ZakharSergeevich/telemetry_box_pcb/docs/Полезная информация для проектирования.docx

Полезная информация для проектирования

1) Tag-Connect TC2050 10-pin pinout

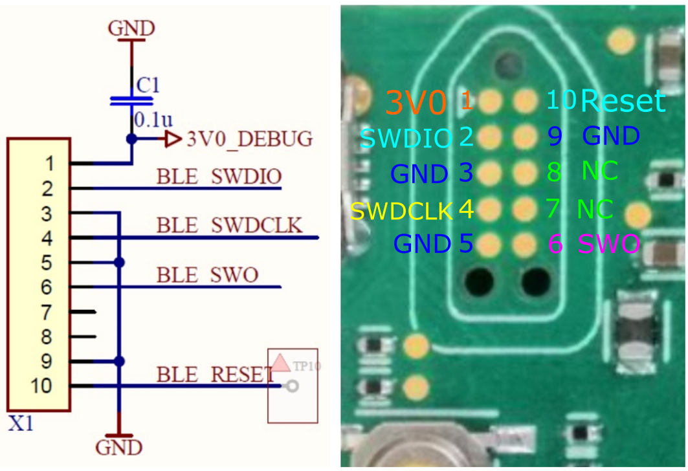
[picture p1: figure]
Рис. 3 FootPrint target устройства

https://habr.com/ru/articles/735422/

2) Пример активной GPS антенны

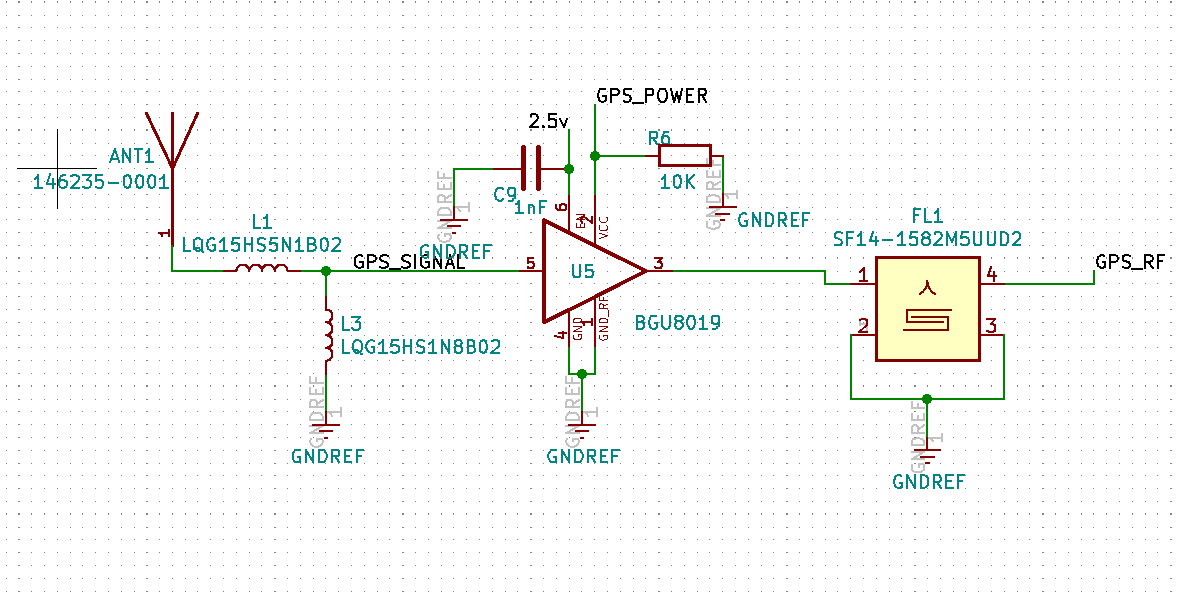
[picture p2: figure]
GPS antenna & amplifier schematic

https://electronics.stackexchange.com/questions/529890/gps-antenna-reference-design
