ZakharSergeevich/telemetry_box_pcb/to_PCBWay/bom/telemetry_box_01_BOM.xlsx

Item # | *Designator | *Qty | Manufacturer | *Mfg Part # | Description / Value | *Package/Footprint | Type | Your Instructions / Notes
1 | A2 | 1 | Taoglas | PCS.68.A | Antennas PCS.68.A Wideband 5G/4G PCB SMD Antenna | 42mm * 10mm | SMD
2 | C1, C2, C6, C7, C44, C45, C46 | 7 | Samsung Electro-Mechanics | CL10A226MO7JZNC | Multilayer Ceramic Capacitors MLCC - SMD/SMT 22uF+/-20% 16V X5R 1 0603 | 603 | SMD
3 | C3, C4, C5, C8, C15, C17, C22, C24, C25, C26, C29, C31, C41 | 13 | Samsung Electro-Mechanics | CL03A104KA3NNNC | Multilayer Ceramic Capacitors MLCC - SMD/SMT 100nF+/-10% 25V X5R 0201 | 201 | SMD
4 | C9 | 1 | Murata | GRM0335C1HR80BA01D | Multilayer Ceramic Capacitors MLCC - SMD/SMT 0.8 pF 50 VDC 0.1 pF 0201 C0G (NP0) | 201 | SMD
5 | C10 | 1 | Murata | GRM0335C1ER50BA01D | Multilayer Ceramic Capacitors MLCC - SMD/SMT 0.5 pF 25 VDC 0.1 pF 0201 C0G (NP0) | 201 | SMD
6 | C11, C12 | 2 | Murata | GRM0335C1E120GA01D | Multilayer Ceramic Capacitors MLCC - SMD/SMT 12 pF 25 VDC 2% 0201 C0G (NP0) | 201 | SMD
7 | C13, C14 | 2 | Murata | GRM0335C1E2R0BA01D | Multilayer Ceramic Capacitors MLCC - SMD/SMT 2 pF 25 VDC 0.1 pF 0201 C0G (NP0) | 201 | SMD
8 | C16, C20, C23, C27, C30, C42, C43 | 7 | Samsung Electro-Mechanics | CL05A106MP5NUNC | Multilayer Ceramic Capacitors MLCC - SMD/SMT 10uF+/-20% 10V X5R 1005 | 402 | SMD
9 | C18 | 1 | Murata | GRM0335C1E101JA01D | Multilayer Ceramic Capacitors MLCC - SMD/SMT 100 pF 25 VDC 5% 0201 C0G (NP0) | 201 | SMD
10 | C32 | 1 | Murata | GRM0335C1E470FA01D | Multilayer Ceramic Capacitors MLCC - SMD/SMT 47 pF 25 VDC 1% 0201 C0G (NP0) | 201 | SMD
11 | C19 | 1 | Murata | GRM0335C1E821JA01D | Multilayer Ceramic Capacitors MLCC - SMD/SMT 820 pF 25 VDC 5% 0201 C0G (NP0) | 201 | SMD
12 | C21, C28, C37, C38 | 4 | Samsung Electro-Mechanics | CL05A105KO5NNNC | Multilayer Ceramic Capacitors MLCC - SMD/SMT 1uF+/-10% 16V X5R 10 0402 | 402 | SMD
13 | C36 | 1 | no | no | no
14 | C39 | 1 | Murata | GRM1555C1H3R3CA01D | Multilayer Ceramic Capacitors MLCC - SMD/SMT 3.3 pF 50 VDC 0.25 pF 0402 C0G (NP0) | 402 | SMD
15 | J1 | 1 | Molex | 78646-3001 | Memory Card Connectors MICRO SIM CON ASSY 1.45HT PUSHPULL 6CKT
16 | J4 | 1 | Amphenol | 12401832E402A | USB Connectors USB TYPE C RCPT R/A top mount dual SMT
17 | L1 | 1 | Murata | DFE201210U-R47M=P2 | Power Inductors - SMD .47 UH 3.0A | 805 | SMD
18 | L2 | 1 | Murata | LQW15AN4N7B00D | RF Inductors - SMD 4.7 NH +-.1NH | 402 | SMD
19 | L3, L5 | 2 | Murata | LQM18DH100M70L | Power Inductors - SMD Fixed IND 10uH 300mA POWRTRN | 603 | SMD
20 | L4 | 1 | Murata | LQW15AN15NJ00D | RF Inductors - SMD 15 NH 5% | 402 | SMD
21 | L6 | 1 | Murata | LQW15AN12NJ00D | RF Inductors - SMD 12 NH 5% | 402 | SMD
22 | R1 | 1 | YAGEO | RC0201FR-07200KL | Thick Film Resistors - SMD 200 kOhms 50mW 0201 1% | 201 | SMD
23 | R2, R3 | 2 | YAGEO | RC0201FR-07100KL | Thick Film Resistors - SMD 100 kOhms 50mW 0201 1% | 201 | SMD
24 | R4 | 1 | YAGEO | RC0201FR-070RL | Thick Film Resistors - SMD 0 Ohms 50mW 0201 1% | 201 | SMD
25 | R10, R11 | 2 | YAGEO | RC0201FR-7D10KL | Thick Film Resistors - SMD 10 kOhms 50 mW 0201 1% | 201 | SMD
26 | R12 | 1 | YAGEO | RC0201FR-072KL | Thick Film Resistors - SMD 2 kOhms 50mW 0201 1% | 201 | SMD
27 | R13, R14 | 2 | YAGEO | RC0201FR-075K1L | Thick Film Resistors - SMD 5.1 kOhms 50 mW 0201 1% | 201 | SMD
28 | S1 | 1 | Same Sky | SLW-108645-4A-RA-D | Slide Switches 10.8 x 6.4 x 5 mm, 4 mm Raised Slide Actuator, Right-Angle, Through Hole |  | DIP
29 | U1 | 1 | Nordic Semiconductor | nRF52840-QIAA-R | RF System on a Chip - SoC nRF52840-QIAA QFN 73L 7x7 | AQFN-73
30 | U2 | 1 |  | A9G | A9G
31 | U3 | 1 | STMicroelectronics | STBC08PMR | Battery Management 800mA Linear Li Ion batery chargr
32 | U4 | 1 | Texas Instruments | TPS7A2633DRVR | LDO Voltage Regulators 500-mA, 18-V, ultra-low-IQ, high-accuracy, adjustable low-dropout voltage regulator with power good 6-WSON -40 to 125
33 | U5 | 1 | Taoglas | SGGP.12.4.A.02 | Antennas SGGP.12.4.A.02 GPS/GLONASS/Galileo 12*12*4mm SMD Mount Patch |  | SMD
34 | U6 | 1 | NXP | BGU8019X | RF Amplifier Low Noise Amplifier MMIC for GPS |  | SMD
35 | U7 | 1 | Analog Devices | ADP150ACBZ-2.8-R7 | Linear Voltage Regulators 150mA LDO 2.8Vout | WLCSP-4 | SMD
36 | Y1 | 1 | ABRACON | ABM11-32.000MHZ-B7G-T | Crystals CRYSTAL 32.0000MHZ 10PF SMD | 2mm * 1.6mm
37 | Y2 | 1 | ABRACON | ABS04W-32.768KHZ-4-D2-T5 | Crystals CRYSTAL 32.768KHZ 4PF SMD | 1.2mm * 1mm
