ZakharSergeevich/telemetry_box_pcb/telemetry_box_01/telemetry_box_01.step

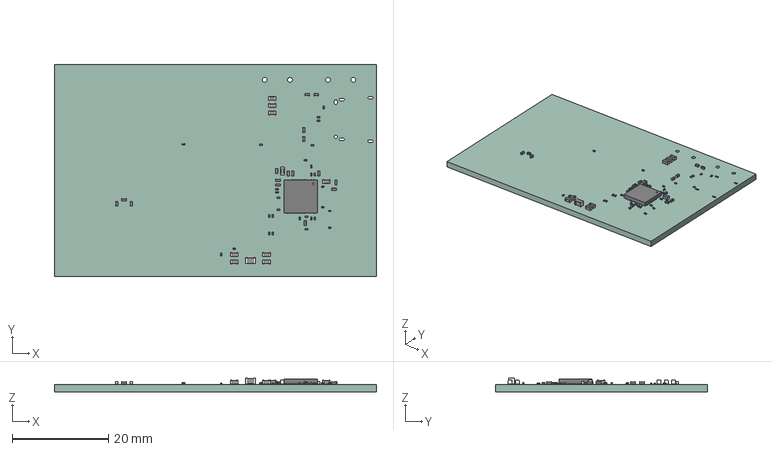
[picture p3: CAD file, 2025-03-20]
telemetry_box_01/telemetry_box_01.step
66.8 x 44.0 x 2.88 mm
telemetry_box_01 PCB
