ZakharSergeevich/telemetry_box_pcb/telemetry_box_01/telemetry_box_01.kicad_pcb

## KiCad design telemetry_box_01/telemetry_box_01.kicad_pcb (2025-06-04)

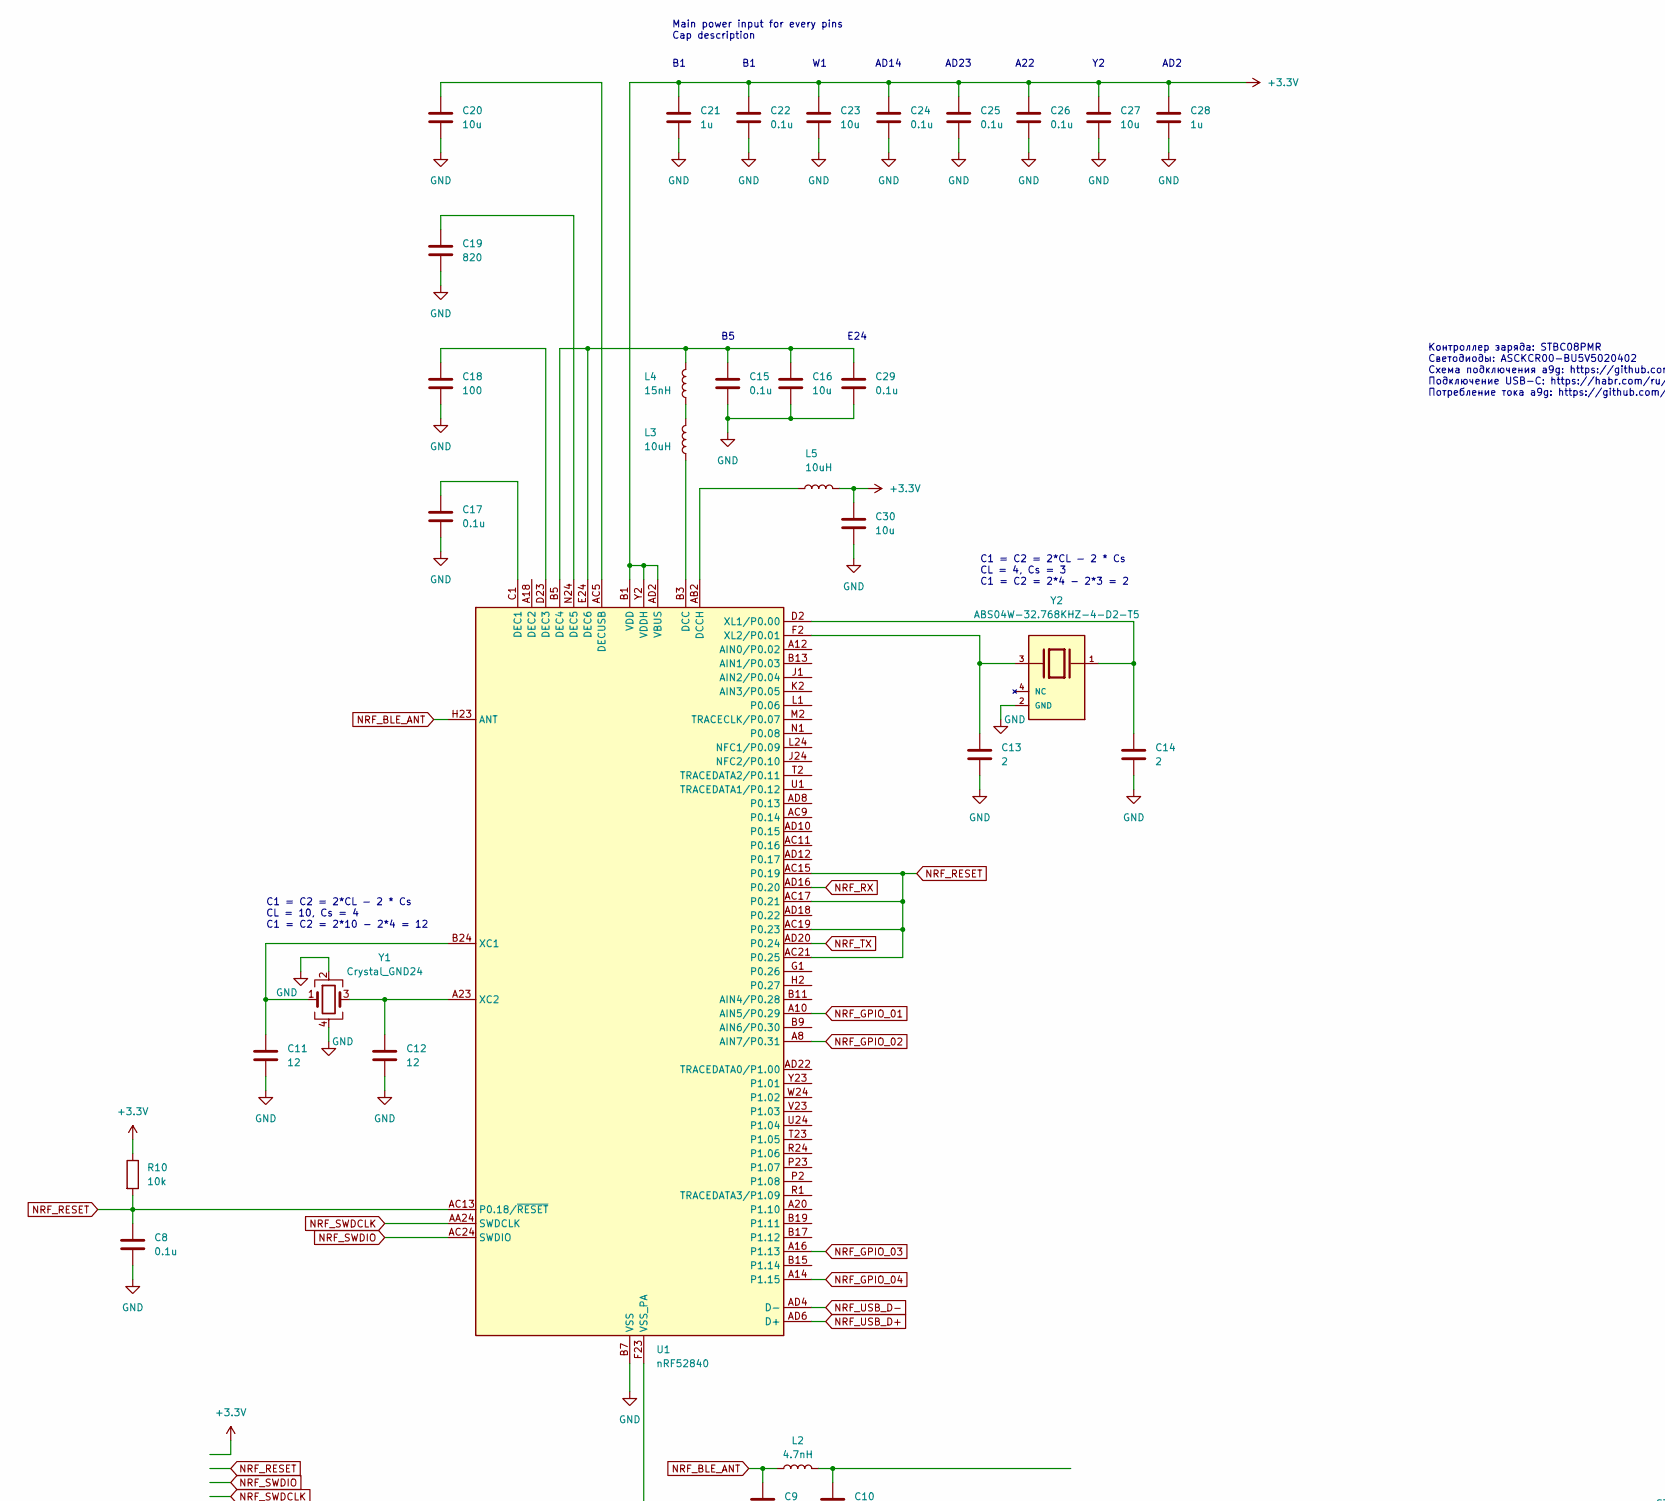
[picture p4: schematic telemetry_box_01.kicad_sch, part in row 1, column 1]

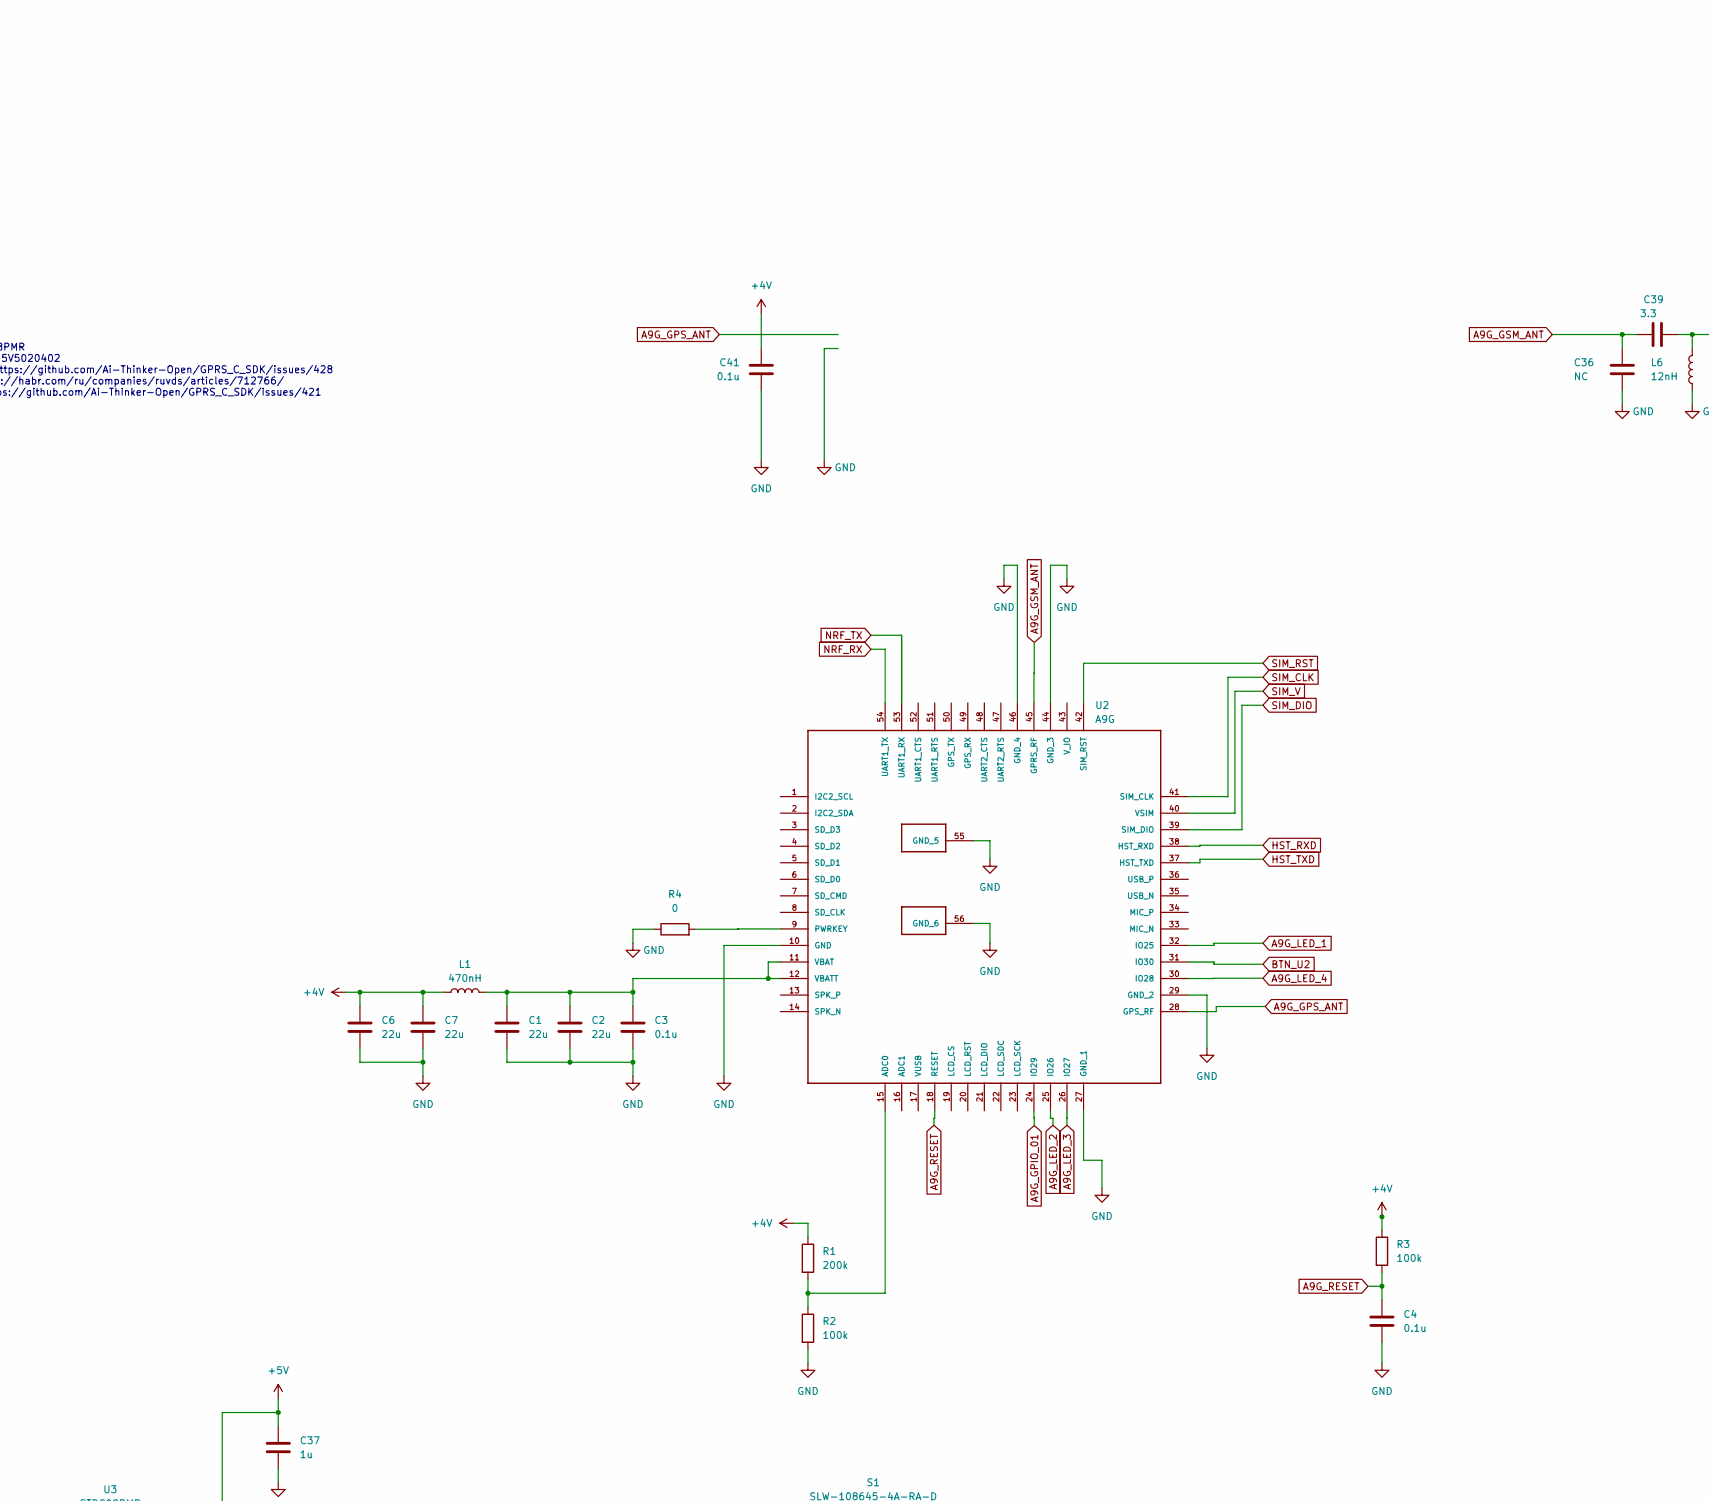
[picture p5: schematic telemetry_box_01.kicad_sch, part in row 1, column 2]

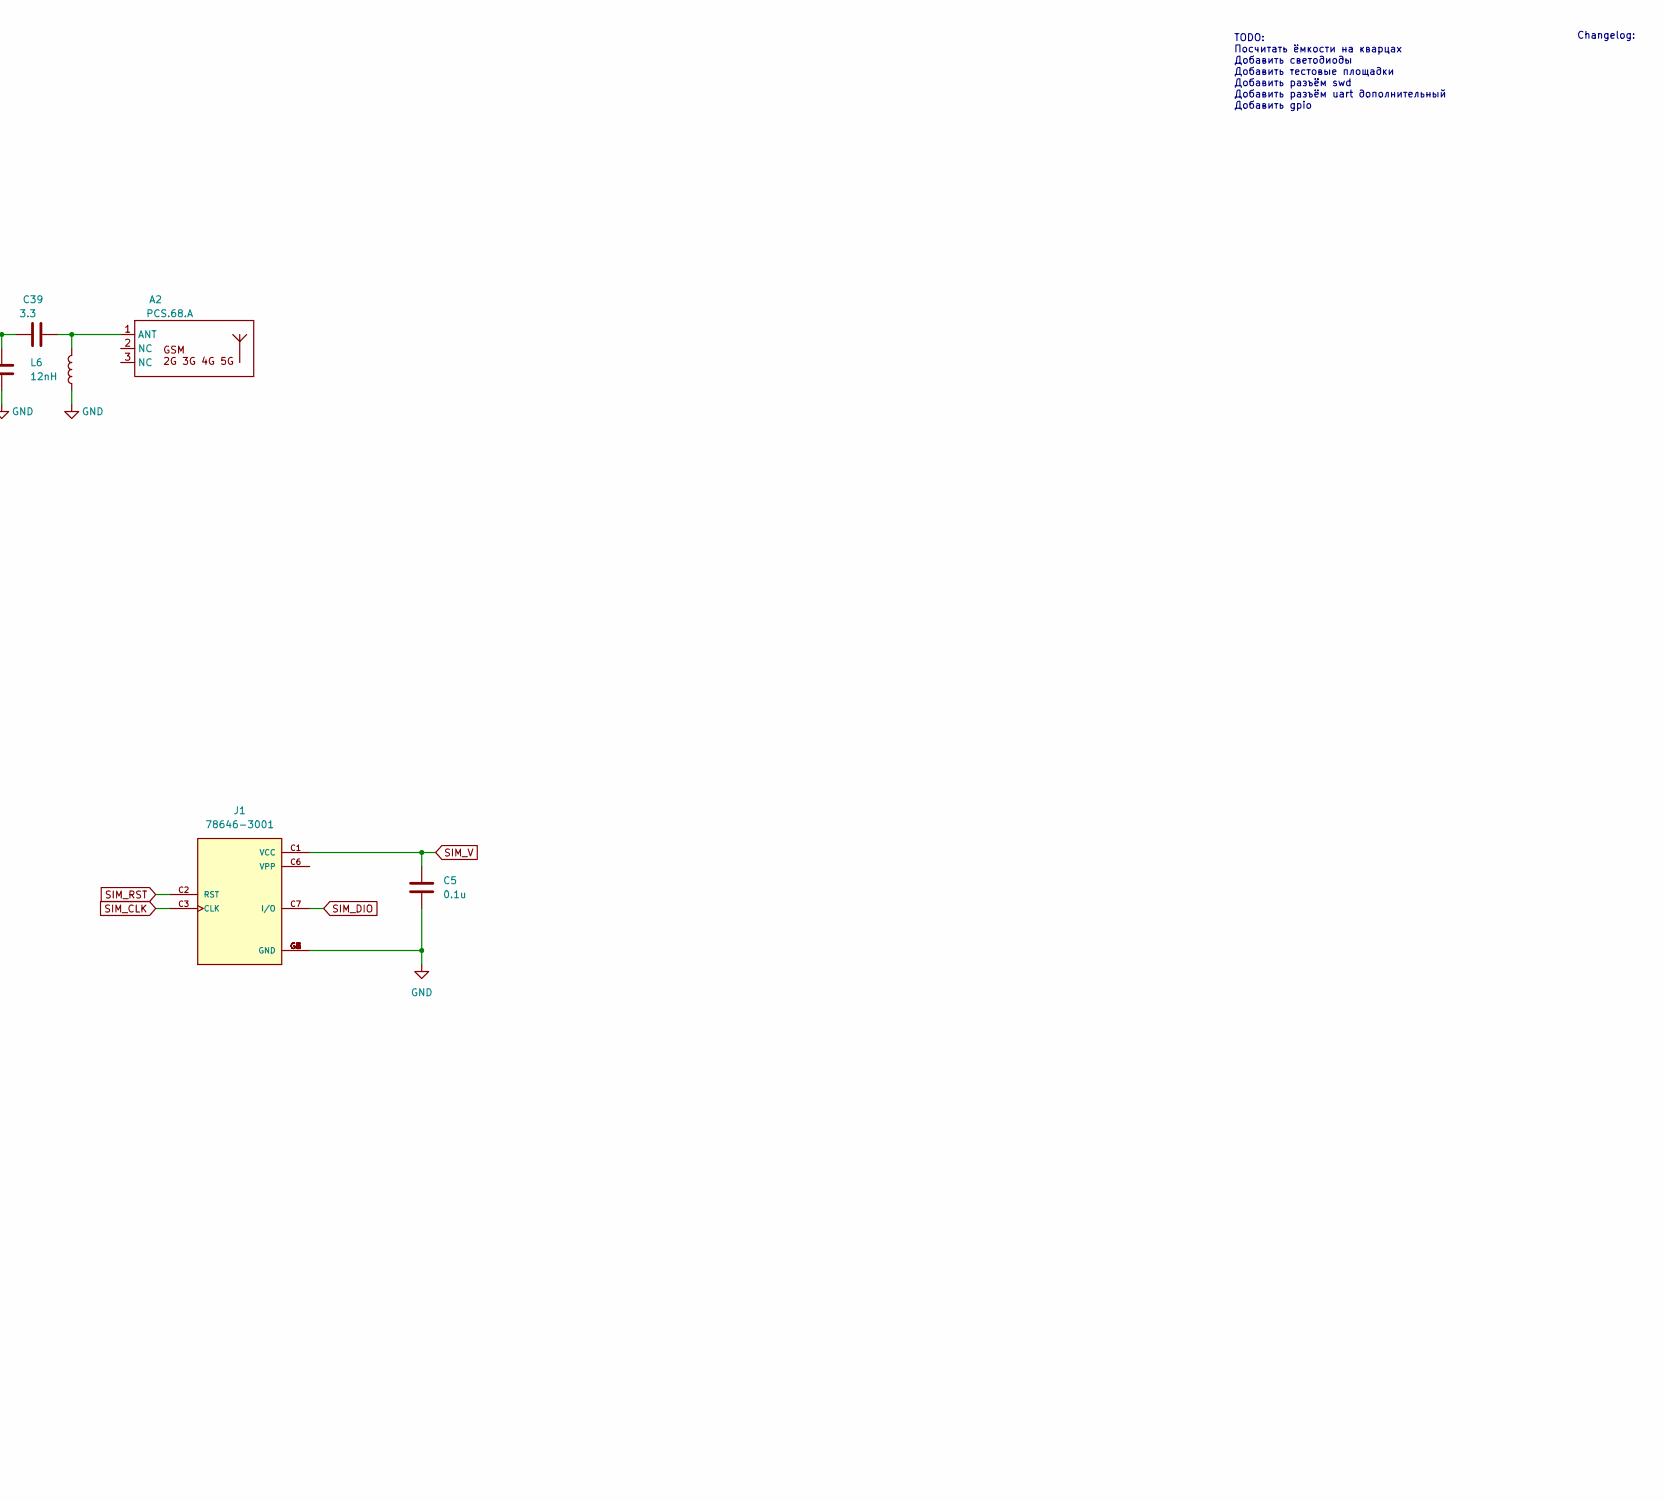
[picture p6: schematic telemetry_box_01.kicad_sch, part in row 1, column 3]

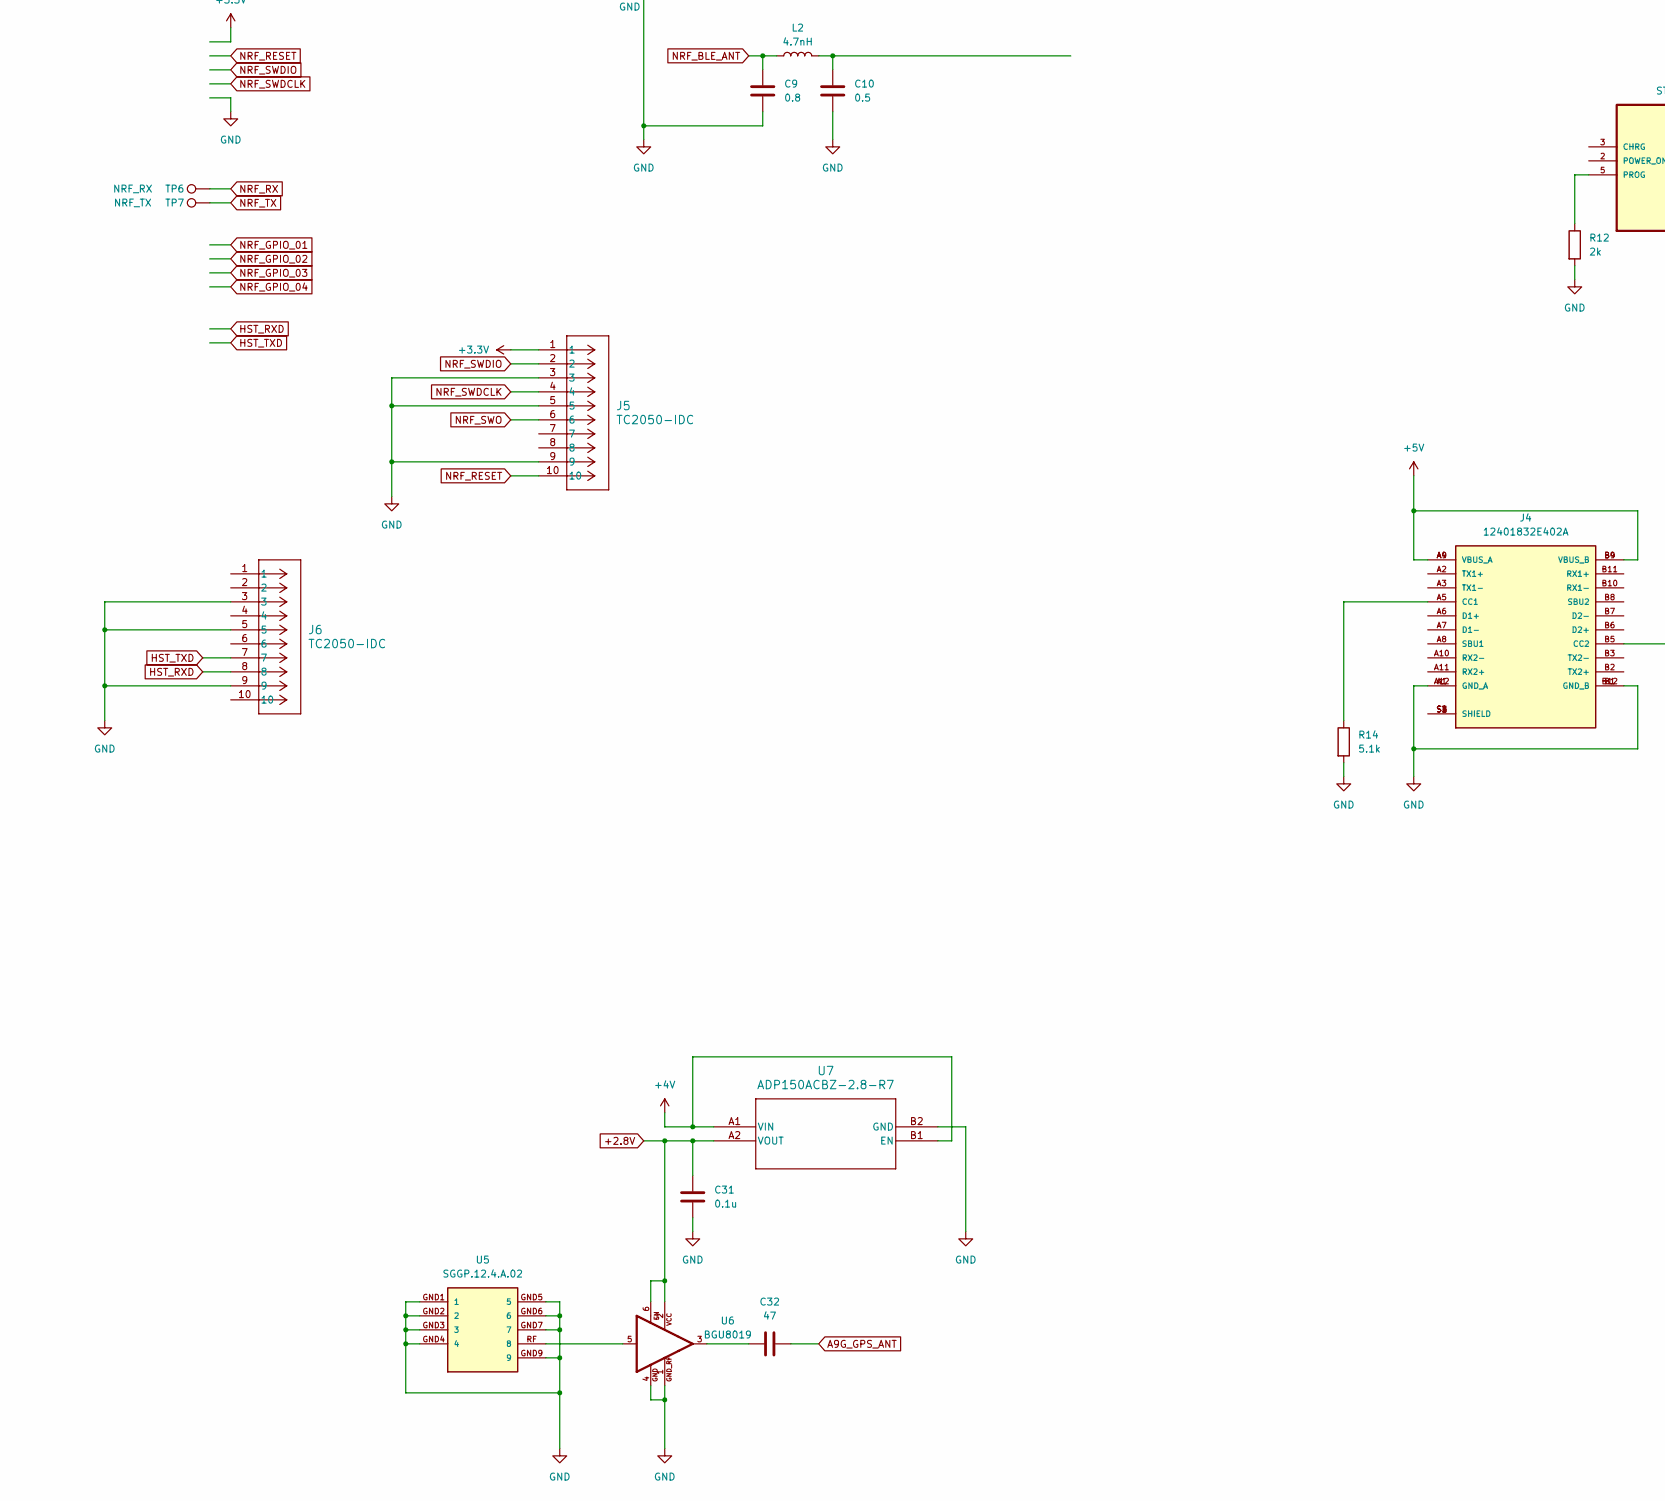
[picture p7: schematic telemetry_box_01.kicad_sch, part in row 2, column 1]

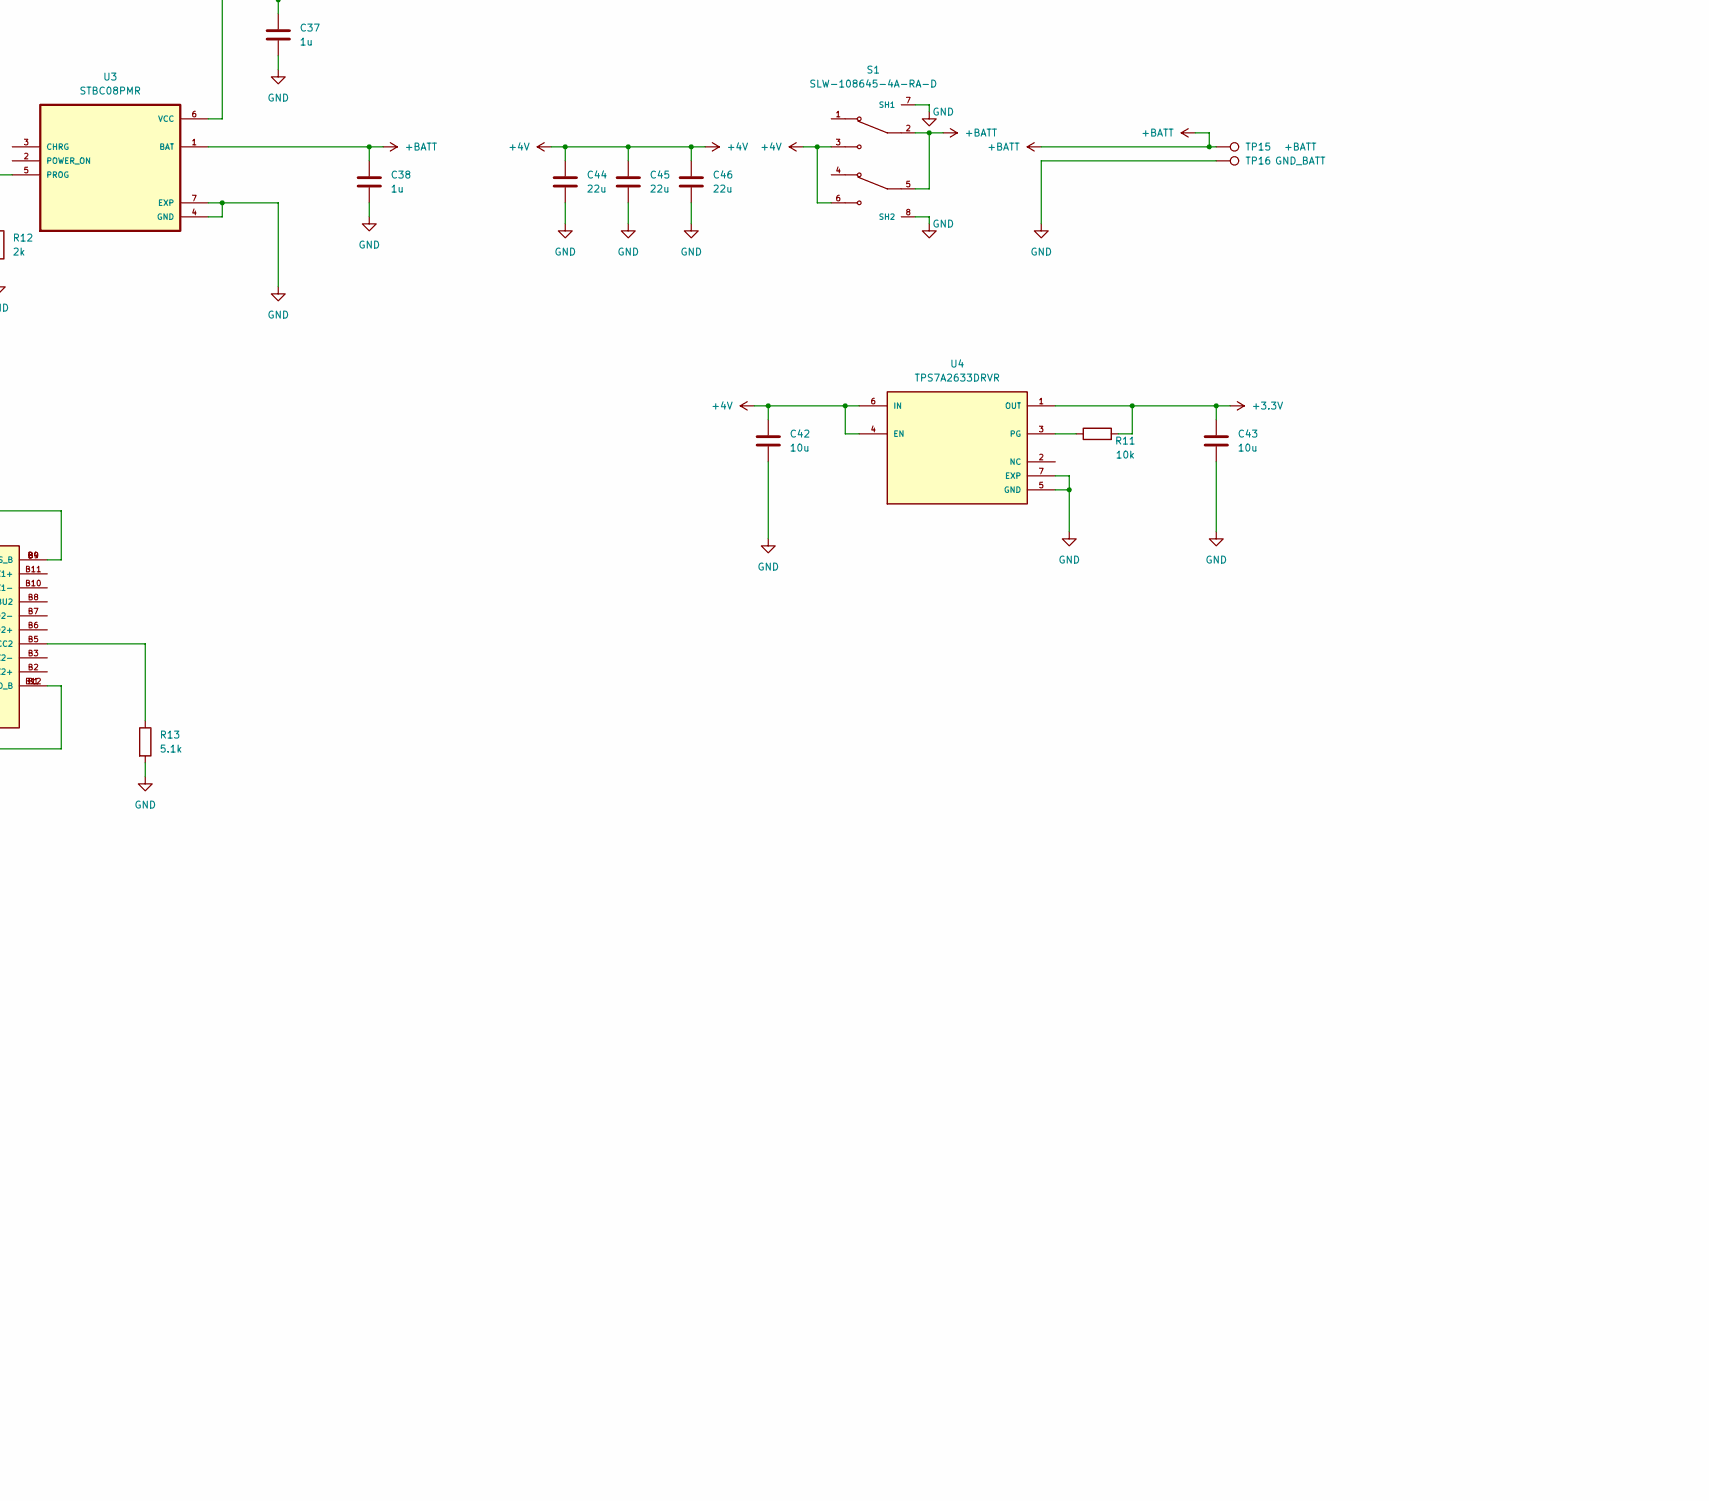
[picture p8: schematic telemetry_box_01.kicad_sch, part in row 2, column 2]

Parts:
A2: PCS.68.A
C1, C2, C6, C7, C44, C45, C46: 22u; C_0603_1608Metric
C3, C4, C5, C8, C15, C17, C22, C24, C25, C26, C29, C31, C41: 0.1u; C_0201_0603Metric
C9: 0.8; C_0201_0603Metric
C10: 0.5; C_0201_0603Metric
C11, C12: 12; C_0201_0603Metric
C13, C14: 2; C_0201_0603Metric
C16, C20, C23, C27, C30, C42, C43: 10u; C_0402_1005Metric
C18: 100; C_0201_0603Metric
C19: 820; C_0201_0603Metric
C21, C28, C37, C38: 1u; C_0402_1005Metric
C32: 47; C_0201_0603Metric
C36: NC; C_0402_1005Metric
C39: 3.3; C_0402_1005Metric
J1: 78646-3001; MOLEX_78646-3001; DIGI-KEY_PART_NUMBER WM9364CT-ND
J4: 12401832E402A; AMPHENOL_12401832E402A; PARTREV X2
J5, J6: TC2050-IDC; CONN_TC2050-IDC_TGC
L1: 470nH; L_0805_2012Metric_Pad1.15x1.40mm_HandSolder
L2: 4.7nH; L_0402_1005Metric
L3, L5: 10uH; L_0603_1608Metric
L4: 15nH; L_0402_1005Metric
L6: 12nH; L_0402_1005Metric
R1: 200k; R_0201_0603Metric
R2, R3: 100k; R_0201_0603Metric
R4: 0; R_0201_0603Metric
R10, R11: 10k; R_0201_0603Metric
R12: 2k; R_0201_0603Metric
R13, R14: 5.1k; R_0201_0603Metric
S1: SLW-108645-4A-RA-D; SW_SLW-108645-4A-RA-D; PARTREV 1.01
TP6: NRF_RX; TestPoint_Pad_D2.0mm
TP7: NRF_TX; TestPoint_Pad_D2.0mm
TP15: +BATT; TestPoint_THTPad_D2.0mm_Drill1.0mm
TP16: GND_BATT; TestPoint_THTPad_D2.0mm_Drill1.0mm
U1: nRF52840; Nordic_AQFN-73-1EP_7x7mm_P0.5mm
U2: A9G; A9
U3: STBC08PMR; SON95P300X300X100-7N; PARTREV 4
U4: TPS7A2633DRVR; SON65P200X200X80-7N
U5: SGGP.12.4.A.02
U6: BGU8019; SOT1232
U7: ADP150ACBZ-2.8-R7; CB_4_3_ADI
Y1: Crystal_GND24; Crystal_SMD_2016-4Pin_2.0x1.6mm
Y2: ABS04W-32.768KHZ-4-D2-T5; XTAL_ABS04W-32.768KHZ-4-D2-T5; PARTREV 12.18.2018

Connections:
+2.8V: C31.1, U6.2, U6.6, U7.A2 (VOUT)
+3.3V: C21.1, C22.1, C23.1, C24.1, C25.1, C26.1, C27.1, C28.1, C30.1, C43.1, J5.1, L5.2, R10.1, R11.2, U1.A22 (VDD), U1.AD2 (VBUS), U1.AD14 (VDD), U1.AD23 (VDD), U1.B1 (VDD), U1.W1 (VDD), U1.Y2 (VDDH), U4.1 (OUT)
+4V: C6.1, C7.1, C41.1, C42.1, C44.1, C45.1, C46.1, L1.1, R1.1, R3.1, S1.3, S1.6, U4.4 (EN), U4.6 (IN), U7.A1 (VIN), U7.B1 (EN)
+5V: C37.1, J4.A4 (VBUS_A), J4.A9 (VBUS_A), J4.B4 (VBUS_B), J4.B9 (VBUS_B), U3.6 (VCC)
+BATT: C38.1, S1.2, S1.5, TP15.1, U3.1 (BAT)
A9G_GPIO_01: U2.24 (IO29)
A9G_GPS_ANT: C32.2, U2.28 (GPS_RF)
A9G_GSM_ANT: C36.1, C39.1, U2.45 (GPRS_RF)
A9G_LED_1: U2.32 (IO25)
A9G_LED_2: U2.25 (IO26)
A9G_LED_3: U2.26 (IO27)
A9G_LED_4: U2.30 (IO28)
A9G_RESET: C4.1, R3.2, U2.18 (RESET)
BTN_U2: U2.31 (IO30)
GND: C1.2, C2.2, C3.2, C4.2, C5.2, C6.2, C7.2, C8.2, C9.2, C10.2, C11.2, C12.2, C13.2, C14.2, C15.2, C16.2, C17.2, C18.2, C19.2, C20.2, C21.2, C22.2, C23.2, C24.2, C25.2, C26.2, C27.2, C28.2, C29.2, C30.2, C31.2, C36.2, C37.2, C38.2, C41.2, C42.2, C43.2, C44.2, C45.2, C46.2, J1.C5 (GND), J1.G1 (GND), J1.G2 (GND), J1.G3 (GND), J1.G4 (GND), J1.G5 (GND), J1.G6 (GND), J4.A1 (GND_A), J4.A12 (GND_A), J4.B1 (GND_B), J4.B12 (GND_B), J5.3, J5.5, J5.9, J6.3, J6.5, J6.9, L6.1, R2.2, R4.1, R12.2, R13.2, R14.2, S1.7 (SH1), S1.8 (SH2), TP16.1, U1.B7 (VSS), U1.EP (VSS), U1.F23 (VSS_PA), U2.10 (GND), U2.27 (GND_1), U2.29 (GND_2), U2.44 (GND_3), U2.46 (GND_4), U2.55 (GND_5), U2.56 (GND_6), U3.4 (GND), U3.7 (EXP), U4.5 (GND), U4.7 (EXP), U5.GND1 (1), U5.GND2 (2), U5.GND3 (3), U5.GND4 (4), U5.GND5 (5), U5.GND6 (6), U5.GND7 (7), U5.GND9 (9), U6.1, U6.4, U7.B2 (GND), Y1.2, Y1.4, Y2.2 (GND)
HST_RXD: J6.8, U2.38 (HST_RXD)
HST_TXD: J6.7, U2.37 (HST_TXD)
NRF_BLE_ANT: C9.1, L2.1, U1.H23 (ANT)
NRF_GPIO_01: U1.A10 (AIN5/P0.29)
NRF_GPIO_02: U1.A8 (AIN7/P0.31)
NRF_GPIO_03: U1.A16 (P1.13)
NRF_GPIO_04: U1.A14 (P1.15)
NRF_RESET: C8.1, J5.10, R10.2, U1.AC13 (P0.18/~RESET), U1.AC15 (P0.19), U1.AC17 (P0.21), U1.AC19 (P0.23), U1.AC21 (P0.25)
NRF_RX: TP6.1, U1.AD16 (P0.20), U2.54 (UART1_TX)
NRF_SWDCLK: J5.4, U1.AA24 (SWDCLK)
NRF_SWDIO: J5.2, U1.AC24 (SWDIO)
NRF_SWO: J5.6
NRF_TX: TP7.1, U1.AD20 (P0.24), U2.53 (UART1_RX)
NRF_USB_D+: U1.AD6 (D+)
NRF_USB_D-: U1.AD4 (D-)
unnamed: A2.1 (ANT), C39.2, L6.2
unnamed: C10.1, L2.2
unnamed: C32.1, U6.3
unnamed: J4.A5 (CC1), R14.1
unnamed: J4.B5 (CC2), R13.1
unnamed: J4.S1 (SHIELD), J4.S2 (SHIELD), J4.S3 (SHIELD), J4.S4 (SHIELD)
unnamed: L3.2, L4.1
unnamed: L3.1, U1.B3 (DCC)
unnamed: L5.1, U1.AB2 (DCCH)
unnamed: C17.1, U1.C1 (DEC1)
unnamed: C18.1, U1.D23 (DEC3)
unnamed: C15.1, C16.1, C29.1, L4.2, U1.B5 (DEC4), U1.E24 (DEC6)
unnamed: C19.1, U1.N24 (DEC5)
unnamed: C20.1, U1.AC5 (DECUSB)
unnamed: C11.1, U1.B24 (XC1), Y1.1
unnamed: C12.1, U1.A23 (XC2), Y1.3
unnamed: C14.1, U1.D2 (XL1/P0.00), Y2.1
unnamed: C13.1, U1.F2 (XL2/P0.01), Y2.3
unnamed: R1.2, R2.1, U2.15 (ADC0)
unnamed: R4.2, U2.9 (PWRKEY)
unnamed: C1.1, C2.1, C3.1, L1.2, U2.11 (VBAT), U2.12 (VBATT)
unnamed: R12.1, U3.5 (PROG)
unnamed: R11.1, U4.3 (PG)
unnamed: U5.RF (8), U6.5
SIM_CLK: J1.C3 (CLK), U2.41 (SIM_CLK)
SIM_DIO: J1.C7 (I/O), U2.39 (SIM_DIO)
SIM_RST: J1.C2 (RST), U2.42 (SIM_RST)
SIM_V: C5.1, J1.C1 (VCC), U2.40 (VSIM)

Notes on the sheet:
C1 = C2 = 2*CL - 2 * Cs CL = 4, Cs = 3 C1 = C2 = 2*4 - 2*3 = 2
Changelog:
A22
C1 = C2 = 2*CL - 2 * Cs CL = 10, Cs = 4 C1 = C2 = 2*10 - 2*4 = 12
E24
Main power input for every pins Cap description
AD14
AD23
TODO: Посчитать ёмкости на кварцах Добавить светодиоды Добавить тестовые площадки Добавить разъём swd Добавить разъём uart дополнительный Добавить gpio
AD2
Контроллер заряда: STBC08PMR Светодиоды: ASCKCR00-BU5V5020402 Схема подключения a9g: https://github.com/Ai-Thinker-Open/GPRS_C_SDK/issues/428 Подключение USB-C: https://habr.com/ru/companies/ruvds/articles/712766/ Потребление тока a9g: https://github.com/Ai-Thinker-Open/GPRS_C_SDK/issues/421

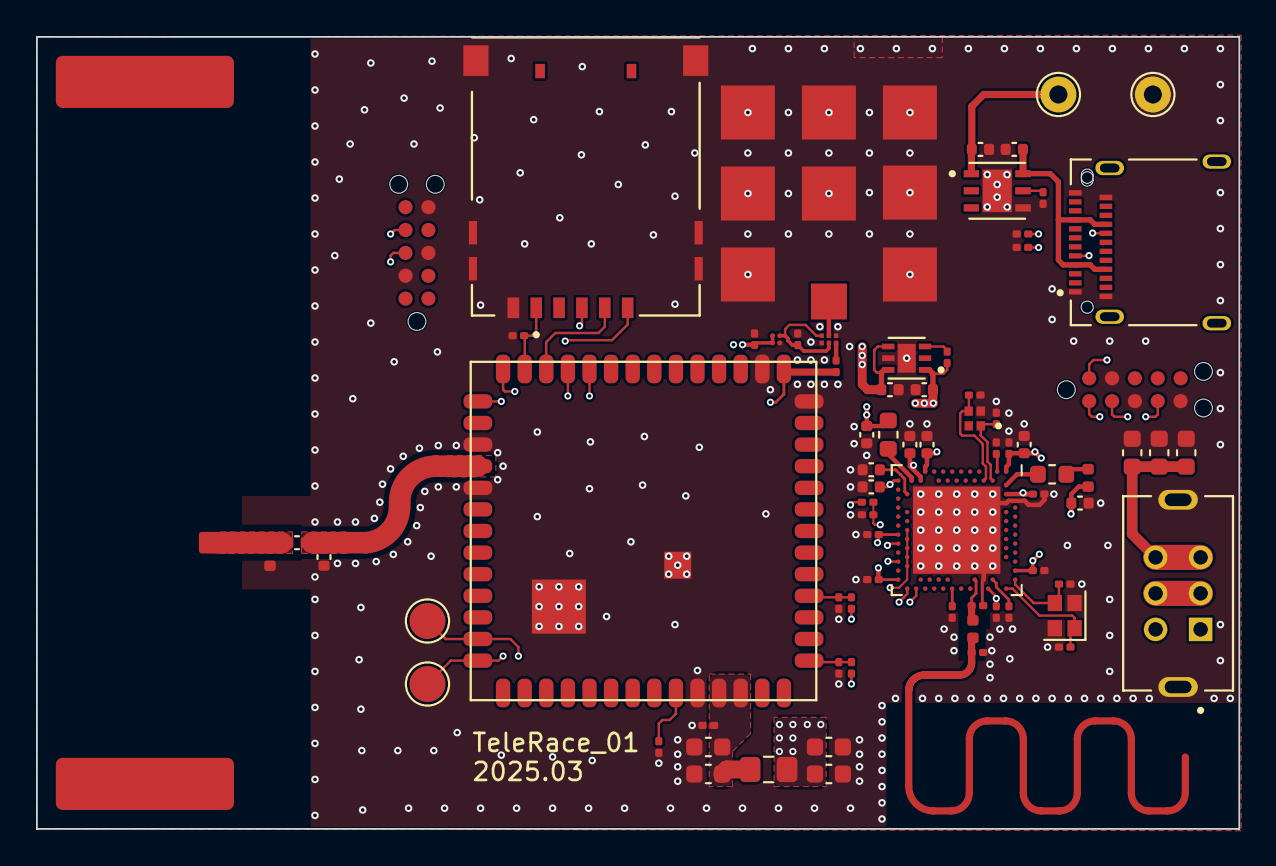
[picture p9: board telemetry_box_01.kicad_pcb from above]

Board: 4 copper layers, 66.8 x 44.0 mm, 76 parts (0 on the bottom side), 45 nets.
