ZakharSergeevich/telemetry_box_pcb/(commit log)

2023-10-28 feat(board): EMI protected PCB
    [telemetry_box_01.kicad_pcb, telemetry_box_01.kicad_sch]
2023-10-28 fix(vias): blind vias have been removed to optimize production
    [telemetry_box_01.kicad_pcb, telemetry_box_01.kicad_sch]
2023-10-28 docs(production): gerber, BOM, position files for PCBWay
    [telemetry_box_01-B_Cu.gbr, telemetry_box_01-B_Mask.gbr, telemetry_box_01-B_Paste.gbr, telemetry_box_01-B_Silkscreen.gbr, telemetry_box_01-Edge_Cuts.gbr, telemetry_box_01-F_Cu.gbr, telemetry_box_01-F_Mask.gbr, telemetry_box_01-F_Paste.gbr]
2025-03-20 feat(board): optimization of component placement -reduce product dimensions -remove GPS antenna -add power to the SMA connector for external GPS antenna -move debug pins -replace ble smd antenna with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
    [telemetry_box_01.kicad_pcb, telemetry_box_01.kicad_sch]
2025-04-04 feat(board): installation GPS antenna, power switch, tag-connect on PCB
    [telemetry_box_01.kicad_pcb, telemetry_box_01.kicad_sch]
2025-06-04 fix(production): gerber, BOM, position files for PCBWay -successful production of modules
    [telemetry_box_01-B_Cu.gbr, telemetry_box_01-B_Mask.gbr, telemetry_box_01-B_Paste.gbr, telemetry_box_01-B_Silkscreen.gbr, telemetry_box_01-Edge_Cuts.gbr, telemetry_box_01-F_Cu.gbr, telemetry_box_01-F_Mask.gbr, telemetry_box_01-F_Paste.gbr]
